IDiAL-IMSL/Edurob-CAD/Gripper/BOM_Gripper.pdf

# Bill of Materials (BOM) – Gripper Assembly

Pos. | Description | Notes | Qty
1 | Dynamixel XL330 Actuator (XLXC-330) | Motor | 1
2 | Gripper Body | | 1
3 | Gripper Elbow Joint | | 4
4 | Gripper Arm Left Top | | 1
5 | Gripper Arm Right Top | | 1
6 | Gripper Arm Left Bottom | | 1
7 | Gripper Arm Right Bottom | | 1
8 | Gripper Finger Cylinder | | 2
9 | Socket Head Cap Screw M3x20 (DIN 912) | | 6
10 | Socket Head Cap Screw M3x6 (DIN 912) | | 6
11 | Socket Head Cap Screw M2x20 (DIN 912) | | 4
12 | Countersunk Screw M3 (ISO 7040) | | 6
13 | Hex Nut M2 (ISO 4032) | | 4
14 | Washer 3.2 (DIN 125-A) | | 2
