IDiAL-IMSL/Edurob-CAD/Base/Chassis.step

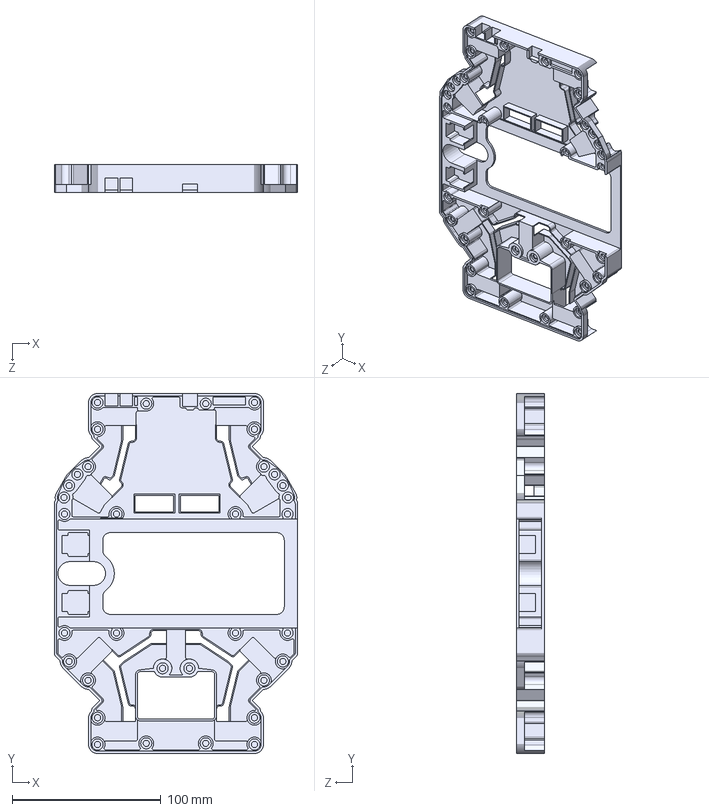
[picture p1: CAD file, 2026-06-17]
Base/Chassis.step
163.6 x 242.1 x 18.6 mm
