IDiAL-IMSL/Edurob-CAD/Sensors/LIDAR/RPLidar_A1M8.step

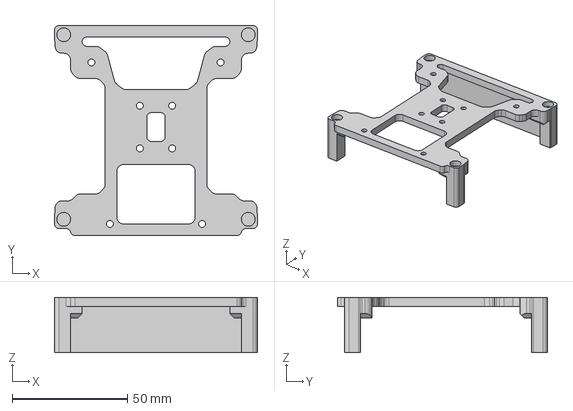
[picture p3: CAD file, 2026-03-19]
Sensors/LIDAR/RPLidar_A1M8.step
88.0 x 91.0 x 24.0 mm
