IDiAL-IMSL/Edurob-CAD/Base/Motor_Mount.step

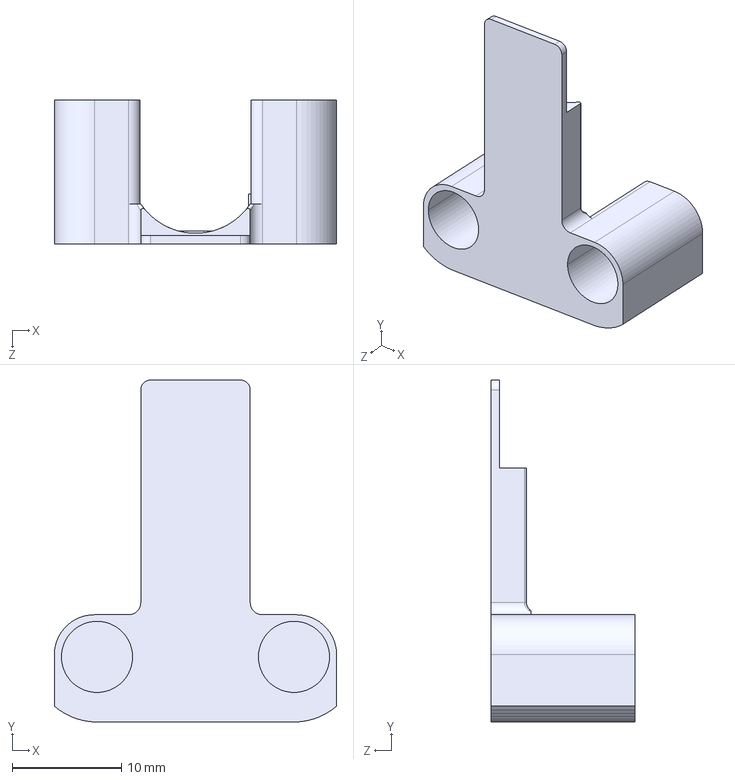
[picture p4: CAD file, 2026-03-19]
Base/Motor_Mount.step
25.8 x 31.2 x 13.2 mm
