IDiAL-IMSL/Edurob-CAD/Base/USB_Spacer.step

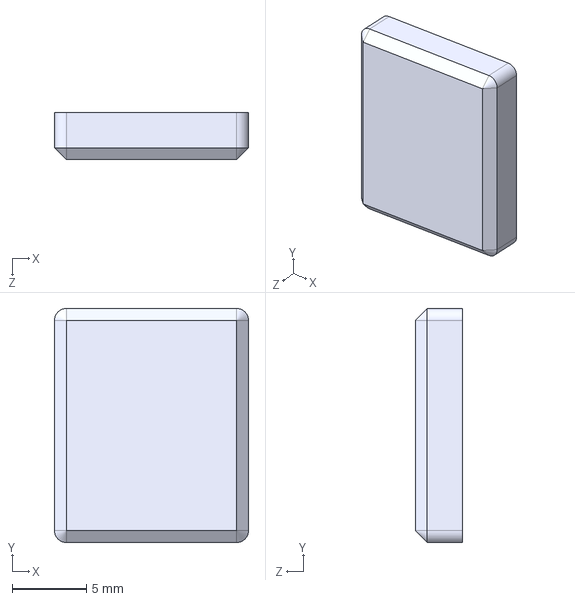
[picture p5: CAD file, 2026-03-19]
Base/USB_Spacer.step
13.1 x 15.8 x 3.20 mm
