IDiAL-IMSL/Edurob-CAD/Base/Fuse_Holder.step

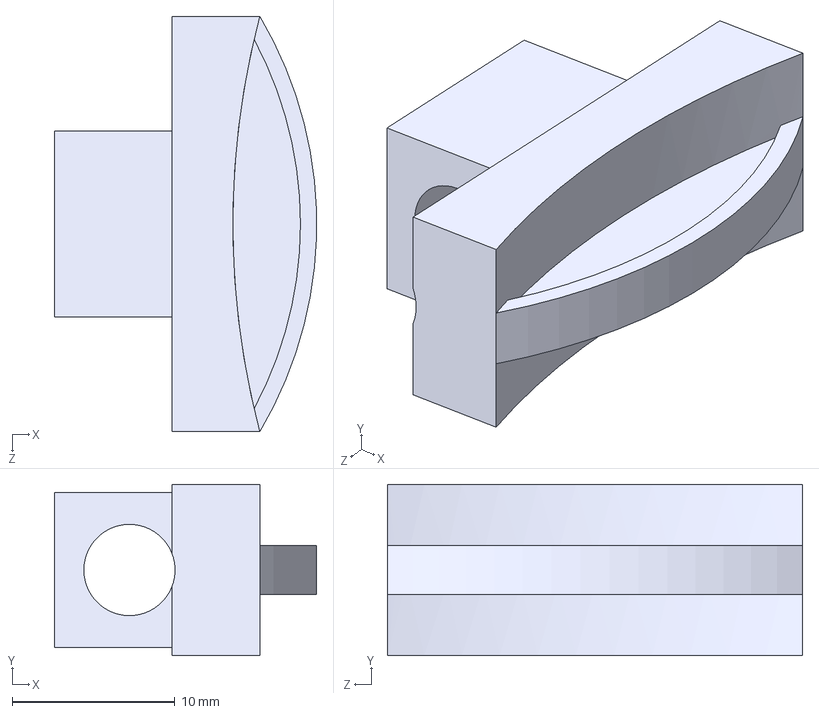
[picture p6: CAD file, 2026-03-19]
Base/Fuse_Holder.step
16.1 x 10.5 x 25.5 mm
