IDiAL-IMSL/Edurob-CAD/(commit log)

2026-03-19 Import EduRobV2 CAD models
    [2F_Servo_Gripper.step, Chassis.step, Fuse_Holder.step, Motor_Mount.step, RPLidar_A1M8.step, USB_Spacer.step]
2026-06-17 Update the CADs to current version.
    [2F_Servo_Gripper.step, Chassis.step]
